parkmoses02/equilibrium/PCB/폐기/RevI_manufacturing_preview.png

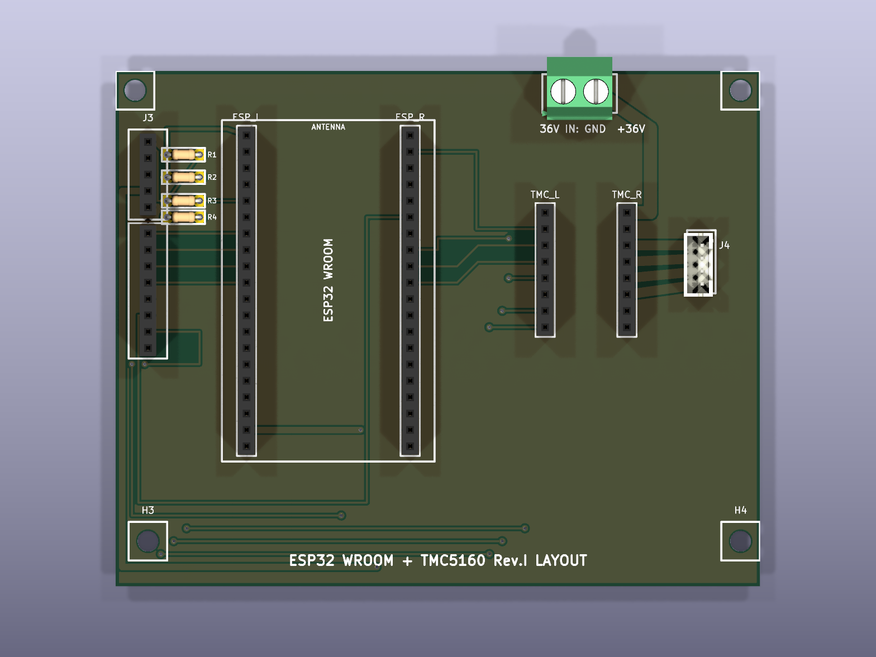
PCB/폐기/RevI_manufacturing_preview.png
