parkmoses02/equilibrium/README.md

# equilibrium
Double Inverted Pendulum Control - 6인 팀 프로젝트  이중 역진자 시스템의 동역학 모델링과 제어 알고리즘 구현을 위한 공동 개발 저장소입니다.

프로젝트 목표:
- 정확한 비선형/선형화 모델 개발
- 다양한 제어 기법(LQR, PID, MPC 등) 비교 및 적용
- 시뮬레이션 환경 구축 및 성능 분석
- 코드 품질과 문서화 유지
