parkmoses02/equilibrium/PCB/폐기/HARDWARE_SPEC.md

# 이중역진자 제어 PCB 하드웨어 사양

작성 기준: 2026-08-06  
상태: Rev.C WROOM 배선 완료 사양

## 1. 시스템 구성

- 제어기: Freenove ESP32 WROOM 보드
- 스테퍼 드라이버: TMC5160T Pro V1.0 모듈
- 스테퍼 모터: NEMA17, 17HS4401, 1.8° bipolar
- 엔코더: 광전 증분형 로터리 엔코더 38S6G5-B-G24N, 600 PPR
- 주 전원: DC 36 V
- 용도: 이중역진자 구동 및 위치/속도 계측

## 2. ESP32 WROOM 보드

- 보드: Freenove ESP32 WROOM
- 로직 전압: 3.3 V
- 보드 전원 입력: 5 V 핀 사용 예정
- 핀 피치: 2.54 mm
- GPIO6~GPIO11: Flash 연결 핀이므로 사용 금지
- GPIO16~GPIO17: WROOM 보드에서 사용 가능하지만 Rev.C PCB에서는 NC로 유지
- 카메라가 없는 WROOM 보드이므로 WROVER-CAM 카메라 핀 충돌 조건은 해당 없음
- ESP32 GPIO에는 3.3 V를 초과하는 신호를 직접 입력하지 않음

## 3. 스테퍼 모터

- 모델: 17HS4401
- 형식: 2상 bipolar hybrid stepper motor
- 프레임: NEMA17
- 스텝각: 1.8°/step
- 기본 스텝 수: 200 full steps/revolution
- 정격 상전류: 1.68 A/phase
- 정격 상전압: 3.27 V
- 상저항: 1.95 Ω ±10%
- 상인덕턴스: 4.4 mH ±20%
- 유지토크: 0.45 N·m
- 절연 등급: Class B
- 절연저항: 100 MΩ min (500 V DC)
- 중량: 0.3 kg
- 모터 길이: 40 mm
- 데이터시트 표기 동작환경: -20~+50 °C, 15~95% RH
- 결선: A+, A-, B+, B-의 4선
- 구동 방식: TMC5160의 전류 제한형 chopper 구동
- 주의: 36 V는 드라이버의 VMOT 전압이며 모터 코일에 36 V를 직접 연속 인가하는 방식이 아님

## 4. TMC5160 드라이버 모듈

- 모듈: TMC5160T Pro V1.0
- 모터 전원 VMOT: 36 V 입력 예정
- 로직 전원 VIO: ESP32와 동일한 3.3 V
- 제어: STEP/DIR + SPI
- 필수 신호: EN, STEP, DIR, MOSI, MISO, SCK, CS
- 모터 출력: A1, A2, B1, B2
- DIAG0/DIAG1: 현재 미사용
- ENCA/ENCB/ENCN: 현재 미사용
- 모듈 상단 보조 핀은 실제 모듈에 헤더가 납땜되지 않았으므로 캐리어 PCB에서도 사용하지 않는 방향
- 실제 연속 허용전류는 모듈의 방열판, 냉각 조건 및 제조사 사양을 기준으로 최종 확인 필요
- TMC5160 모듈 방열판 보유 및 사용 예정
- PCB에는 냉각팬 커넥터와 팬 전원회로를 넣지 않음
- 시운전 중 과열 시 외부 송풍으로 보조하고 SPI의 과열 사전 경고 상태를 확인

## 5. 엔코더

- 모델: 38S6G5-B-G24N
- 분해능: 600 PPR
- 케이블 길이: 약 1.5 m
- 형식: 광전 증분형, A/B 2상
- 출력: NPN open-collector로 알려져 있으나 제품 라벨/판매 사양으로 최종 확인 필요
- 전원 범위: 판매 사양에 따라 DC 5~24 V 또는 8~24 V로 표기되므로 실물 라벨 확인 필요
- 권장 PCB 인터페이스:
  - 엔코더를 5 V로 구동할 수 있는지 실물 사양 확인
  - A/B 출력에 각각 3.3 V 기준 외부 pull-up 적용
  - 초기값: 2.2~4.7 kΩ pull-up, 최고 RPM과 실측 파형에 따라 조정
  - 약 1.5 m 케이블의 노이즈 대책으로 입력 직렬 저항, ESD 보호 및 3.3 V Schmitt-trigger buffer 권장
  - 엔코더 케이블은 모터 배선과 분리하고 가능하면 shielded twisted-pair 사용
  - 엔코더 GND와 PCB GND 공통 연결
- 600 PPR는 A/B 4체배 시 최대 2400 counts/revolution으로 처리 가능

## 6. 전원 구조

- 입력 전원: DC 36 V
- 36 V 직접 공급 대상: TMC5160 VMOT
- 5 V 필요 대상: ESP32 보드, 엔코더(5 V 구동 가능 모델인 경우)
- 3.3 V 대상: TMC5160 VIO 및 ESP32 신호 pull-up
- 시스템 전원은 외부 power supply에서 36 V와 필요한 저전압을 공급하는 방향
- 36 V는 VMOT에만 연결하며 ESP32에는 직접 연결하지 않음
- ESP32용 5 V를 외부에서 별도로 공급하거나, 외부 DC-DC를 사용하는 것으로 잠정 결정
- 36 V와 5 V 입력은 분리하고 GND는 공통으로 구성
- 전원 입력부에 필요한 항목:
  - 역극성 보호
  - 퓨즈 또는 resettable fuse
  - 36 V 이상의 충분한 정격을 가진 TVS 검토
  - TMC5160 가까이에 bulk capacitor 및 ceramic bypass capacitor
  - 5 V regulator 입력/출력 capacitor

### 6.1 외부 36 V 전원공급기와 입력 배선 사양

- 권장 전원공급기: 정전압형 DC 36 V, 정격출력 3 A 이상
  - 36 V/5 A 제품도 사용할 수 있으나, 전원공급기의 큰 정격전류가 PCB로 그대로 흐르지 않도록 PCB 입력 앞에 별도 퓨즈를 둔다.
  - 출력전압 조절형 제품은 PCB 연결 전에 멀티미터로 36 V인지 확인한다.
  - 출력 과전류·단락·과전압·과열 보호 기능이 있는 제품을 우선한다.
  - AC 입력 단자와 금속 케이스가 있는 전원공급기는 보호접지(PE), 절연 덮개 및 케이스를 적용한다. AC 주전원 배선은 이 PCB에 연결하지 않는다.
- PSU와 PCB 사이 36 V 입력선:
  - 도체: 연선 구리선(stranded copper)
  - 권장 굵기: AWG18, 약 0.75~0.82 mm²
  - 짧은 시험 배선에서만 AWG20 사용 가능하며, 이 경우에도 3 A 이하 퓨즈를 적용한다.
  - `+36V`와 `GND`는 같은 굵기와 비슷한 길이로 배선한다.
  - 절연 정격은 최소 DC 60 V 이상, 구매 시에는 일반적인 300 V 또는 600 V 정격 전선을 권장한다.
  - 듀퐁 점퍼선, 브레드보드선 및 정격을 알 수 없는 가는 케이블은 VMOT 입력에 사용하지 않는다.
- 퓨즈 및 퓨즈 홀더:
  - 위치: PSU의 `+36V` 출력 직후, 가능한 한 전원공급기 가까이 설치
  - 권장값: 2.5~3 A 지연형(time-delay/slow-blow)을 초기값으로 사용
  - 퓨즈와 홀더 모두 DC 60 V 이상 및 사용 전류 이상의 정격 제품을 사용
  - 모터 가속 시 정상적으로 퓨즈가 끊어지면 실측 입력전류를 확인한 후 조정하며, PCB의 2 A 연속 설계 기준을 임의로 넘기지 않는다.
- PCB 전원 단자:
  - 풋프린트: 5.08 mm pitch, 3핀 단자대
  - 실제 장착 부품은 최소 DC 60 V/5 A 이상, 권장 300 V/8 A 이상의 정격을 확인한다.
  - 단자대의 허용 전선 단면적에 AWG18이 포함되는지 확인한다.
- 페룰 단자:
  - AWG18 전선에는 0.75 mm²용 절연 페룰 사용(E7508 또는 단자대 삽입 깊이에 맞는 동급 규격)
  - 금속 슬리브 길이는 우선 8 mm를 사용하고, 단자대 제조사 권장 피복 제거 길이에 맞춘다.
  - 래칫식 사각 또는 육각 페룰 압착기로 압착하고, 납을 먹인 연선 끝을 나사 단자대에 직접 체결하지 않는다.
  - 압착 후 가볍게 당겨 빠지지 않는지 확인하고, 구리 가닥이 단자 밖으로 노출되지 않게 한다.

권장 연결 순서:

```text
PSU +36V ── 2.5~3 A 지연형 퓨즈 ── AWG18 적색선 + 0.75 mm² 페룰 ── PCB VMOT
PSU GND  ───────────────────────── AWG18 흑색선 + 0.75 mm² 페룰 ── PCB GND
```

초기 통전 전에는 PSU를 끄고 극성 및 단락 여부를 확인한다. 모터 또는 TMC5160 모듈은 VMOT가 인가된 상태에서 연결하거나 분리하지 않는다.

## 7. PCB 배선 설계 기준(잠정)

- PCB: 2 layer 가정
- 동박: 1 oz 가정
- 외층 허용 온도 상승: 10 °C 목표
- 모터 상전류 계산 기준: 1.68 A/phase 정격, 설계 여유를 위해 2.0 A 연속 기준 적용 예정
- VMOT 및 모터 A/B 배선: 전류 기준으로 폭 계산 후 적용
- 신호선: 0.25~0.30 mm 이상 권장
- GND: 양면 ground plane 및 stitching via 적용
- 모터 전류 루프는 짧고 굵게 구성
- SPI/엔코더 신호는 모터 출력 및 VMOT 배선과 이격
- 전원·모터 커넥터와 핀헤더의 정격전류가 PCB 패턴보다 낮지 않은지 확인

### 7.1 전류별 패턴 폭 계산 및 최종 적용값

계산 가정:

- 2층 PCB, 외층 배선
- 1 oz copper, 약 35 µm 두께
- 허용 온도 상승 10 °C
- IPC-2221 외층 경험식 기준의 보수적 1차 계산
- 실제 적용 폭은 계산 최소값보다 넓게 선정

| 배선 종류 | 설계전류 | 계산 최소 폭 | PCB 적용 폭 | 비고 |
|---|---:|---:|---:|---|
| VMOT 36 V | 2.0 A 기준 | 약 0.78 mm | 2.00 mm | bulk capacitor와 TMC 사이를 짧게 구성 |
| 모터 A1/A2/B1/B2 | 2.0 A 연속 기준 | 약 0.78 mm | 1.50 mm | 모터 정격 1.68 A/phase에 여유 적용 |
| 외부 5 V 전원 | 1.0 A 잠정 | 약 0.30 mm | 1.00 mm | ESP32와 엔코더 공급 |
| 3.3 V 로직 | 0.5 A 미만 | 0.30 mm 미만 | 0.50 mm | TMC VIO 및 pull-up |
| SPI/STEP/DIR/EN | 수 mA | 제조 최소폭 이하 | 0.30 mm | 모터선과 이격 |
| 엔코더 A/B | 수 mA | 제조 최소폭 이하 | 0.30 mm | 1.5 m 케이블, 4.7 kΩ pull-up 및 100 Ω 직렬저항 |

패턴 폭보다 핀헤더, 단자대, 납땜 상태 및 TMC5160 모듈의 방열 조건이 먼저 전류 한계가 될 수 있으므로 이 부품들의 정격도 함께 확인한다.

### 7.2 Rev.C WROOM에 적용한 배선 구조

- F.Cu/B.Cu 양면을 사용해 신호 교차를 분리
- F.Cu와 B.Cu에 GND copper zone 적용
- VMOT 및 모터 출력은 신호선보다 넓게 배선
- 엔코더 A/B는 GPIO34/GPIO35에 연결
- 엔코더 입력마다 4.7 kΩ 3.3 V pull-up과 100 Ω 직렬저항 적용
- TMC5160 상단 DIAG0/DIAG1/ENCA/ENCB/ENCN은 미사용 및 캐리어 풋프린트에서 제외
- 냉각팬 회로와 팬 커넥터는 제외
- Freenove ESP32 WROOM 2×20 핀맵 적용
- WROVER-CAM에서 GND였던 위치 중 WROOM의 GPIO17/GPIO16 위치는 GND 연결을 제거하고 NC 처리
- KiCad 10 DRC 결과는 Rev.C 생성 후 별도 보고서 기준
- 잔여 DRC 항목은 사용자 정의 풋프린트 라이브러리 및 silkscreen 겹침 관련 비전기적 경고
- GND zone은 F.Cu/B.Cu 양면 모두 채운 상태로 저장

## 8. 배선 후 제작 전 확인 필요 항목

1. 외부 power supply의 5 V 출력 제공 여부와 최대 전류
2. 구매할 36 V 전원공급기의 정확한 모델, 보호 기능 및 출력 단자 구조
3. TMC5160T Pro 모듈의 정확한 구매 링크 또는 뒷면 사진
4. 엔코더 실물 라벨 및 케이블 색상별 기능(V+, GND, A, B, shield)
5. 모터 예상 최고 회전속도와 연속 운전시간
6. 사용할 전원·모터·엔코더 커넥터 종류와 정격
7. PCB 동박 1 oz/2 oz 선택과 보드 제작업체 최소 선폭/간격
8. Freenove WROOM 실물의 핀열 간격과 방향 1:1 출력 확인
9. 실제 장착할 5.08 mm 전원 단자대의 전압·전류·허용 전선 규격 확인

## 9. 참고 자료

- Analog Devices TMC5160 제품 정보: https://www.analog.com/en/products/tmc5160.html
- TMC5160 데이터시트: https://www.analog.com/media/en/technical-documentation/data-sheets/tmc5160a_datasheet_rev1.18.pdf
- Freenove ESP32 WROOM 제품 핀맵: 사용자 제공 이미지 기준

> 이 문서는 PCB 설계를 위한 작업 사양이다. 모델명이 같은 모터와 엔코더도 판매처에 따라 전기 사양이 달라질 수 있으므로, 최종 배선 및 부품 선정 전에 실물 라벨과 구매 사양을 우선한다.

## 10. Rev.E 커넥터 및 전원 확정 사양 (2026-08-08)

- 사용 조건: 제어 UI 사용을 위해 ESP32 USB를 항상 PC에 연결한다.
- 외부 5 V 입력 단자와 36 V→5 V 변환 회로는 PCB에서 제외한다.
- ESP32와 엔코더의 5 V는 ESP32 USB 5 V 레일에서 공급한다.
- 36 V 입력은 TMC5160의 VMOT 전원에만 사용하며 ESP32 5 V 핀에 연결하지 않는다.

| 위치 | 용도 | 최종 실장 부품 | 피치/핀 수 | 비고 |
|---|---|---|---|---|
| U1 | Freenove ESP32 WROOM | 1열 암소켓 2개 | 2.54 mm, 1×20 ×2 | 보드 탈착식 |
| U2 | TMC5160T Pro | 1열 암소켓 2개 | 2.54 mm, 1×8 ×2 | 모듈 방열판 공간 확보 |
| J2 | 예비 GPIO | 1열 암소켓 | 2.54 mm, 1×8 | IO32, IO33 포함 |
| J3 | 엔코더 | 1열 암소켓 | 2.54 mm, 1×5 | A, B, GND, USB +5V, GND |
| J4 | 스테퍼 모터 | JST-PH B4B-PH-K PCB 수헤더 | 2.00 mm, 1×4 | A2, A1, B2, B1 순서 |
| J1 | 36 V 입력 | 2핀 나사 단자대 | 5.08 mm, 1×2 | GND, +36V 순서 |

### 구매·조립 조건

- J4 하우징은 JST PHR-4, PCB 수헤더는 B4B-PH-K 계열을 사용한다.
- JST-PH는 정격 여유가 크지 않으므로 정품 접점과 제조사 지정 압착 공구를 사용하고, 접점 규격에 맞는 AWG24 연선을 사용한다.
- 17HS4401의 1.68 A/상 연속 운전 시 커넥터 및 케이블 온도를 반드시 확인한다. 커넥터가 뜨거워지면 전류를 낮추거나 JST-VH 등 상위 전류 정격 커넥터로 변경한다.
- 듀퐁 점퍼선은 모터 출력에 사용하지 않는다.
- J1 단자대는 최소 DC 60 V/5 A 이상, AWG18 수용 제품으로 선정한다.
- PSU–PCB 배선은 AWG18 연선과 0.75 mm² 페룰을 사용한다.
- USB 전원이 끊기면 ESP32와 엔코더도 꺼진다. 36 V만 공급해서는 제어부가 동작하지 않는다.
- 외부 5 V를 ESP32 5 V 핀에 별도로 주입하지 않는다.

### Rev.F 3D 모델 연결

- U1: 1×20, 2.54 mm 암소켓 2개
- U2: 1×8, 2.54 mm 암소켓 2개
- J2: 1×8, 2.54 mm 암소켓 1개
- J3: 1×5, 2.54 mm 암소켓 1개
- J4: JST-PH B4B-PH-K, 4핀 2.00 mm 수직 수헤더
- J1: 2핀 5.08 mm 수평 인입 나사 단자대
- R1~R4: DIN0204, 피치 5.08 mm 축형 저항
- ESP32 WROOM 및 TMC5160 모듈 본체는 전용 STEP 모델이 없어 소켓만 표시한다.
- 3D 모델은 조립 방향과 기구 간섭 확인용이며 Gerber와 전기적 연결에는 영향을 주지 않는다.

### Rev.G 모듈 핀열 간격 수정

- ESP32 WROOM U1 좌우 핀열 중심 간격: 27.94 mm에서 **25.40 mm**로 수정
- TMC5160 U2 좌우 핀열 중심 간격: 15.24 mm에서 **12.70 mm**로 수정
- 두 모듈 모두 중앙 위치를 유지하고 좌우 핀열을 각각 1.27 mm 안쪽으로 이동
- 같은 핀열의 상하 피치는 기존과 동일한 2.54 mm
- 이전 Rev.F 및 그 이전 버전은 모듈 핀열 간격 오류가 있으므로 PCB 제작에 사용하지 않는다.
- 최종 발주 전 실물 모듈의 좌우 핀 중심 간격을 캘리퍼스로 다시 확인한다.
