parkmoses02/equilibrium/PCB/폐기/revF_3d_preview.png

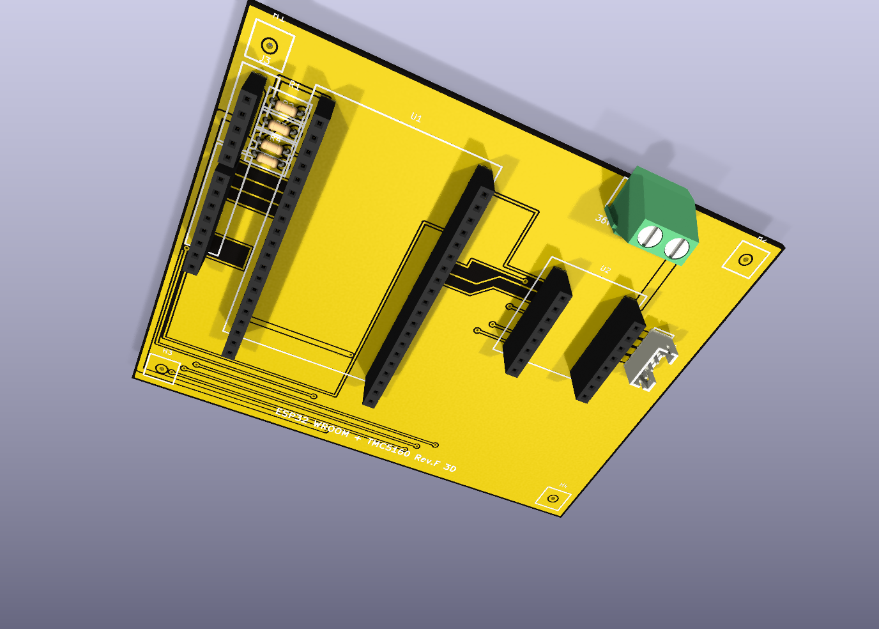
PCB/폐기/revF_3d_preview.png
