parkmoses02/equilibrium/PCB/폐기/revH_3d_preview.png

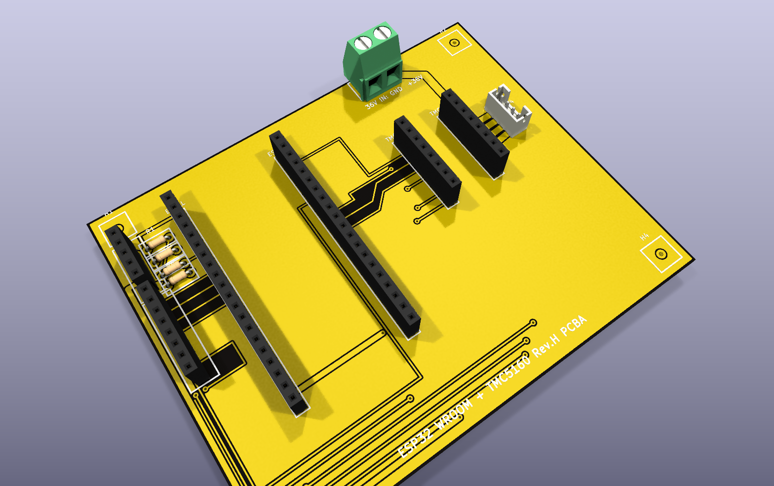
PCB/폐기/revH_3d_preview.png
