parkmoses02/equilibrium/PCB/폐기/revI_top_preview.png

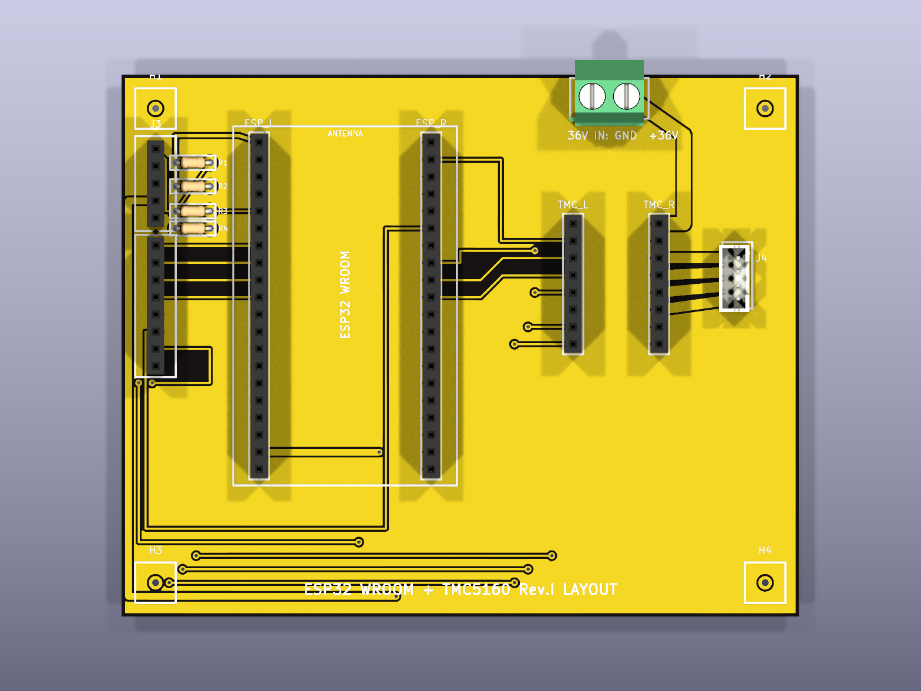
PCB/폐기/revI_top_preview.png
