parkmoses02/equilibrium/PCB/폐기/RevI_manufacturing_drill_report.txt

Drill report for esp32_wroom_tmc5160_carrier_revI_gerber_source.kicad_pcb
Created on 2026-08-10T13:18:06

Copper Layer Stackup:
    =============================================================
    L1 :  F.Cu                      front
    L2 :  B.Cu                      back

Drill file 'esp32_wroom_tmc5160_carrier_revI_gerber_source-PTH.drl' contains
    plated through holes:
    =============================================================
    T1  0.500mm  0.0197"  (15 holes))
    T2  0.750mm  0.0295"  (4 holes))
    T3  1.000mm  0.0394"  (77 holes))
    T4  1.300mm  0.0512"  (2 holes))

    Total plated holes count 98

Drill file 'esp32_wroom_tmc5160_carrier_revI_gerber_source-NPTH.drl' contains
    unplated through holes:
    =============================================================
    T1  3.200mm  0.1260"  (4 holes))

    Total unplated holes count 4
