parkmoses02/equilibrium/PCB/폐기/esp32_wroom_tmc5160_carrier_revE_ph2_connectors.kicad_pcb

## KiCad design PCB/폐기/esp32_wroom_tmc5160_carrier_revE_ph2_connectors.kicad_pcb (2026-08-08)

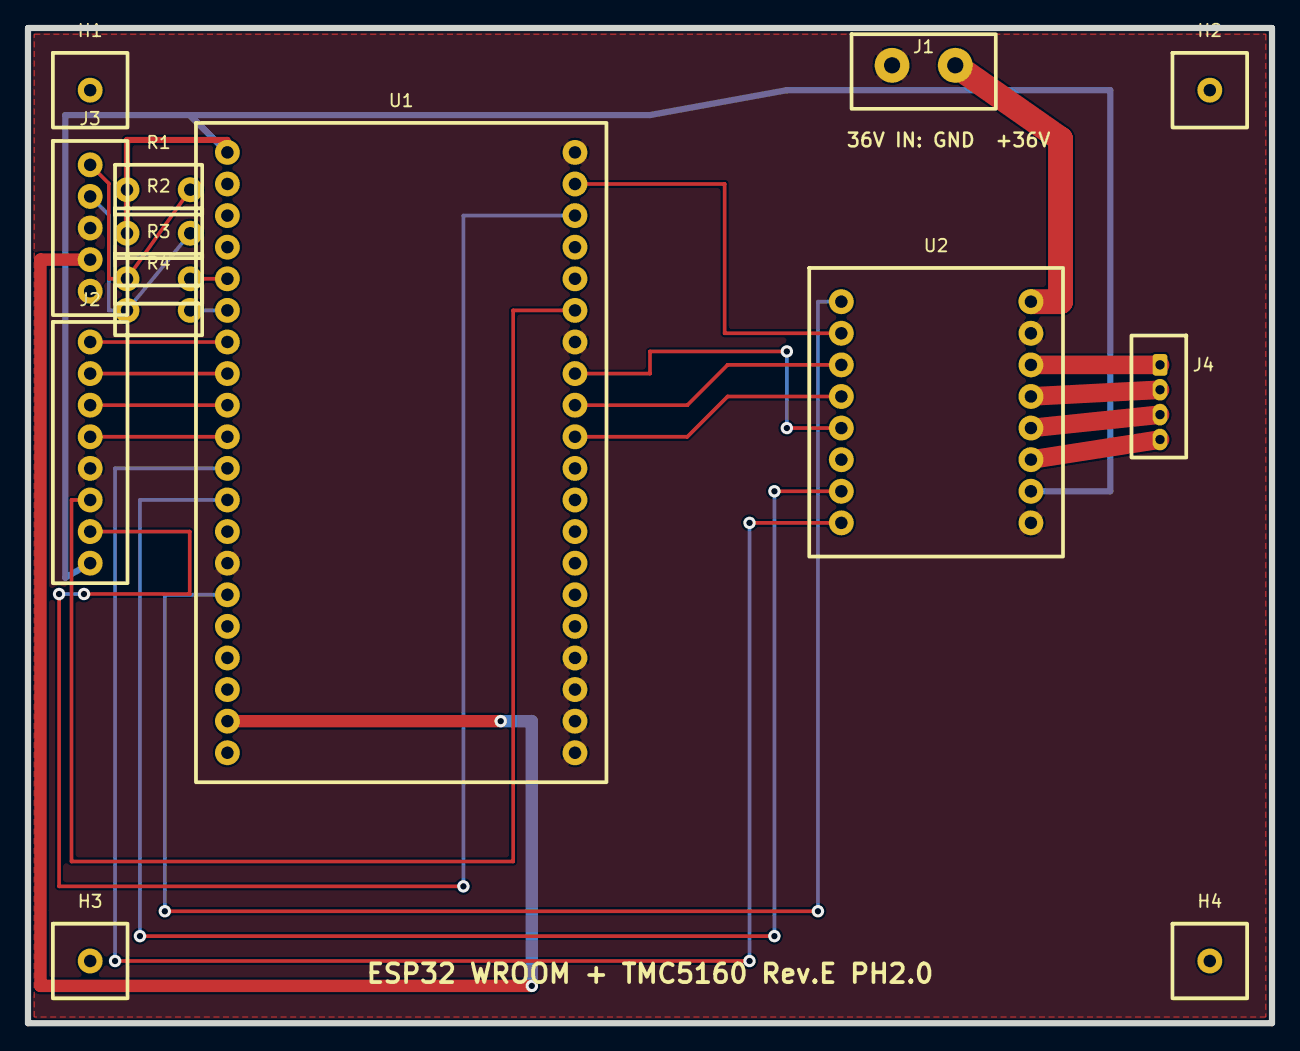
[picture p6: board esp32_wroom_tmc5160_carrier_revE_ph2_connectors.kicad_pcb from above]

Board: 2 copper layers, 100.0 x 80.0 mm, 14 parts (0 on the bottom side), 25 nets.

Parts:
H1, H2, H3, H4: M3_MOUNT
J1: 36V INPUT 2P 5.08mm TERMINAL; TERMINAL_BLOCK_2P_5.08
J2: SPARE GPIO / 1x8 2.54mm FEMALE SOCKET; IO_1x8_2.54_VERTICAL
J3: ENCODER / 1x5 2.54mm FEMALE SOCKET; ENCODER_1x5_2.54_VERTICAL
J4: JST-PH B4B-PH-K 4-pin 2.00mm MALE; JST_PH_B4B-PH-K_1x04_P2.00mm_Vertical
R1: R_A_PULLUP_4K7
R2: R_B_PULLUP_4K7
R3: R_A_SERIES_100R
R4: R_B_SERIES_100R
U1: FREENOVE ESP32 WROOM / 1x20 2.54mm FEMALE SOCKET 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; FREENOVE_ESP32_WROOM_2x20
U2: TMC5160T PRO / 1x8 2.54mm FEMALE SOCKET x2; TMC5160T_PRO_2x8

Connections:
+3V3: J2.8, R1.1, R2.1, U1.L1, U2.15
+5V: J3.4, U1.L19
ENC_A: R3.2, U1.L5
ENC_A_RAW: J3.1, R1.2, R3.1
ENC_B: R4.2, U1.L6
ENC_B_RAW: J3.2, R2.2, R4.1
GND: J1.1, J2.5, J3.3, J3.5, U1.L14, U1.R1, U1.R7, U1.R17, U1.R18, U1.R19, U1.R20, U2.10, U2.16
IO21: J2.6, U1.R6
IO22: J2.7, U1.R3
IO25: J2.3, U1.L9
IO26: J2.4, U1.L10
IO32: J2.1, U1.L7
IO33: J2.2, U1.L8
M_A1: J4.2, U2.12
M_A2: J4.1, U2.11
M_B1: J4.4, U2.14
M_B2: J4.3, U2.13
SPI_CS: U1.R10, U2.4
SPI_MISO: U1.R8, U2.5
SPI_MOSI: U1.R2, U2.2
SPI_SCK: U1.R9, U2.3
TMC_DIR: U1.L11, U2.8
TMC_EN: U1.L15, U2.1
TMC_STEP: U1.L12, U2.7
VMOT: J1.2, U2.9
