parkmoses02/equilibrium/PCB/폐기/esp32_tmc5160_carrier_revA.kicad_pcb

## KiCad design PCB/폐기/esp32_tmc5160_carrier_revA.kicad_pcb (2026-08-06)

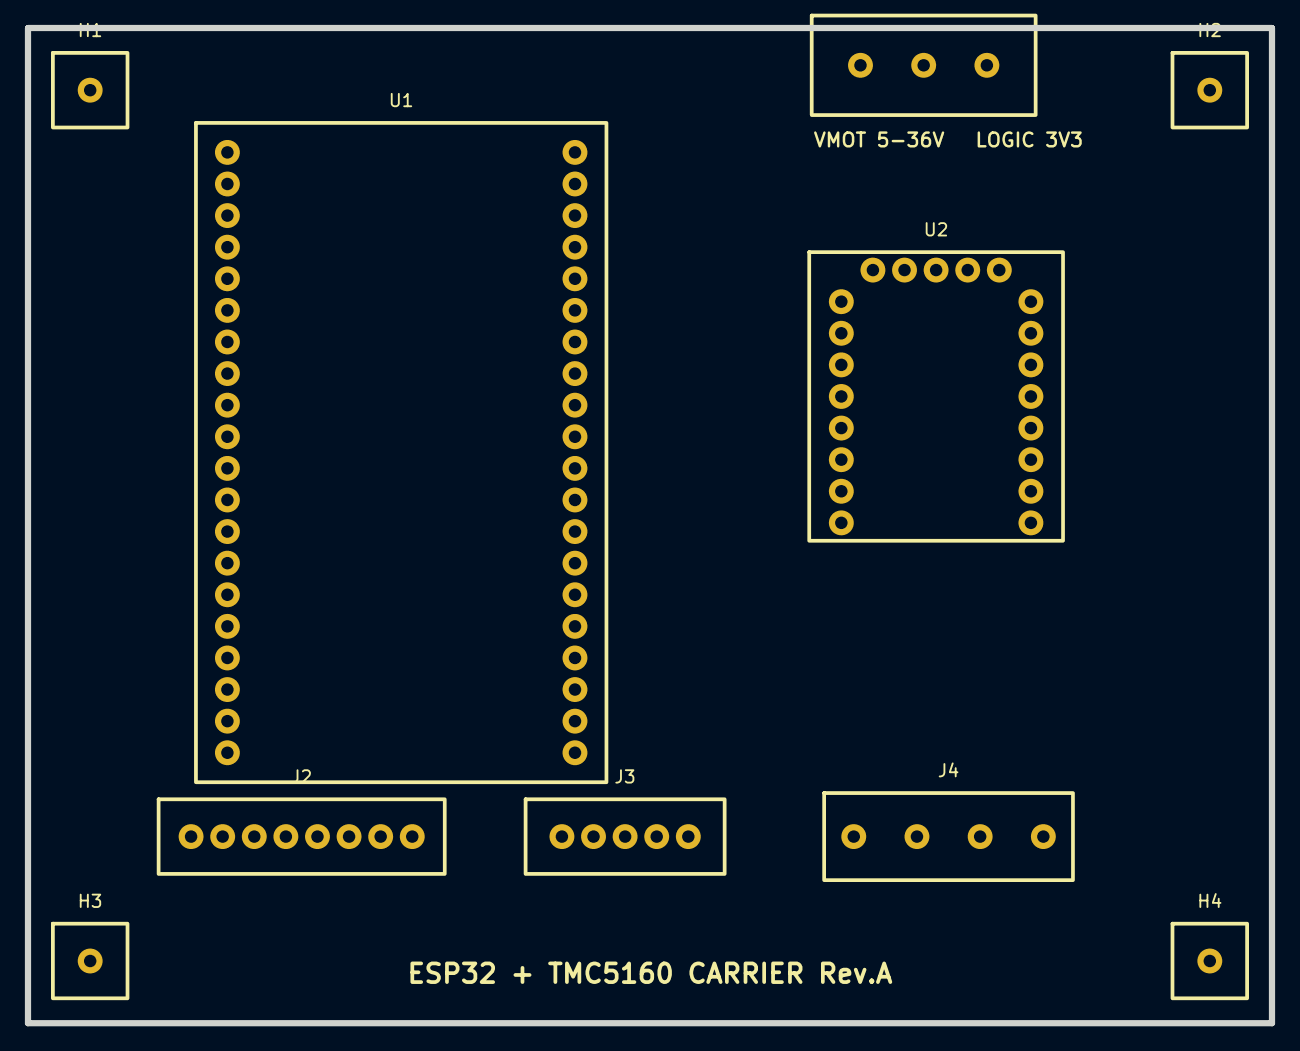
[picture p7: board esp32_tmc5160_carrier_revA.kicad_pcb from above]

Board: 2 copper layers, 100.0 x 80.0 mm, 10 parts (0 on the bottom side), 24 nets, no tracks yet.

Parts:
H1, H2, H3, H4: M3_MOUNT
J1: POWER_VMOT_3P_5.08
J2: IO_1x8_2.54
J3: ENCODER_1x5_2.54
J4: MOTOR_1x4_5.08
U1: FREENOVE_ESP32_WROVER_CAM_2x20
U2: TMC5160T_PRO_2x8

Connections:
+3V3: J2.8, U1.L1, U2.15
+5V: J1.2, J3.4, U1.L19
ENC_A: J3.2, U2.20
ENC_B: J3.1, U2.19
ENC_N: J3.5, U2.21
GND: J1.1, J2.1, J3.3, U1.L14, U1.R1, U1.R7, U1.R11, U1.R12, U1.R20, U2.10, U2.16
IO21: J2.2, U1.R6
IO22: J2.3, U1.R3
IO25: J2.4, U1.L9
IO26: J2.5, U1.L10
IO32: J2.6, U1.L7
IO33: J2.7, U1.L8
M_A1: J4.1, U2.12
M_A2: J4.2, U2.11
M_B1: J4.3, U2.14
M_B2: J4.4, U2.13
SPI_CS: U1.R10, U2.4
SPI_MISO: U1.R8, U2.5
SPI_MOSI: U1.R2, U2.2
SPI_SCK: U1.R9, U2.3
TMC_DIR: U1.L11, U2.8
TMC_EN: U1.L15, U2.1
TMC_STEP: U1.L12, U2.7
VMOT: J1.3, U2.9
