parkmoses02/equilibrium/PCB/폐기/esp32_wroom_tmc5160_carrier_revI_manufacturing_fixed.kicad_pcb

## KiCad design PCB/폐기/esp32_wroom_tmc5160_carrier_revI_manufacturing_fixed.kicad_pcb (2026-08-10)

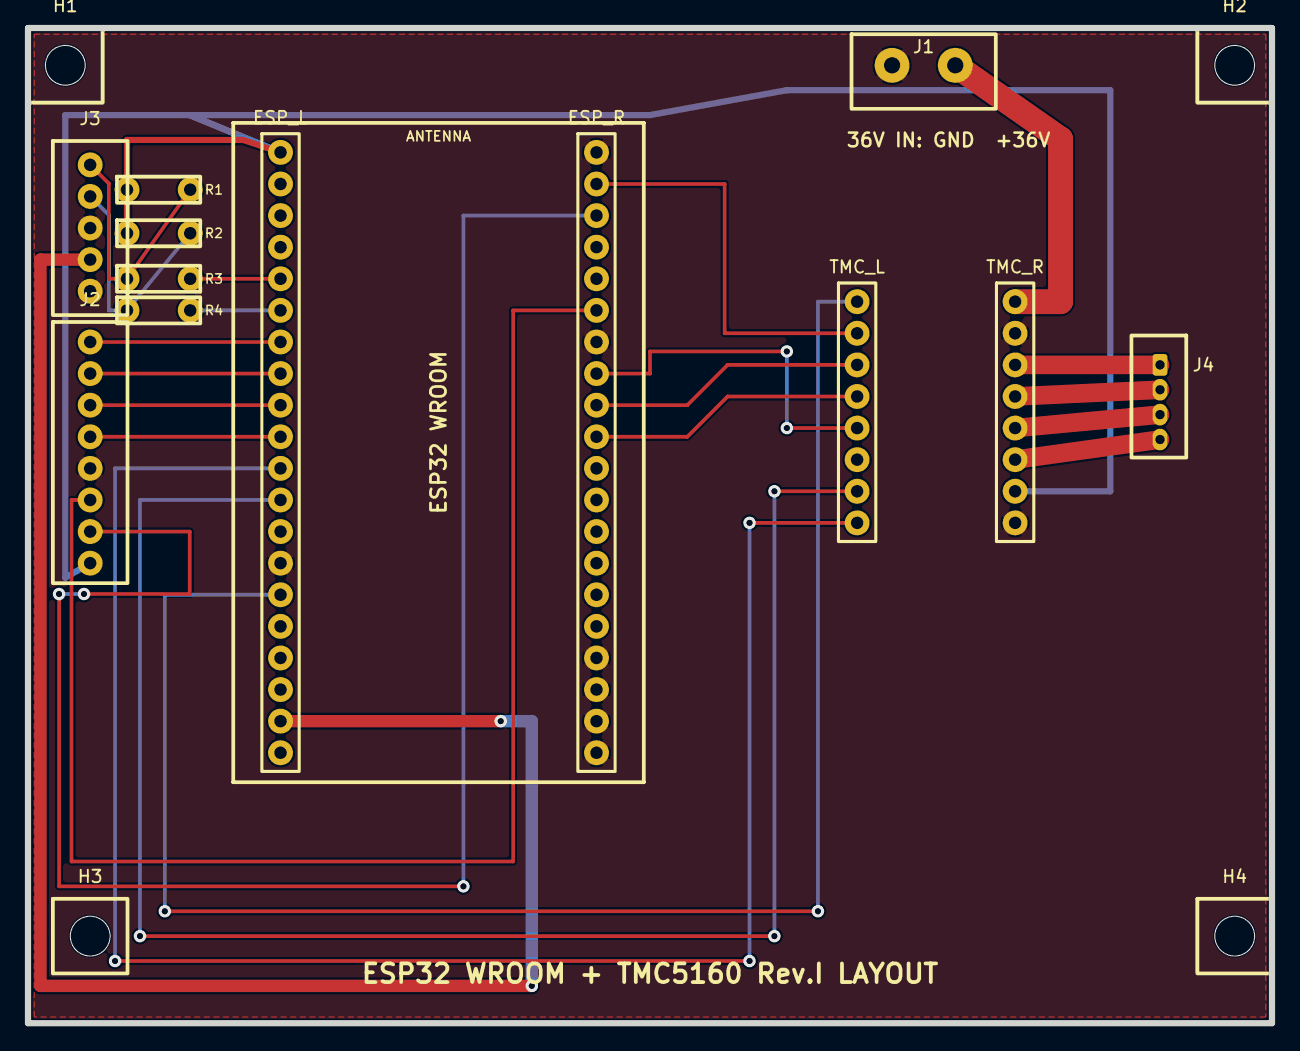
[picture p8: board esp32_wroom_tmc5160_carrier_revI_manufacturing_fixed.kicad_pcb from above]

Board: 2 copper layers, 100.0 x 80.0 mm, 16 parts (0 on the bottom side), 25 nets.

Parts:
ESP_L: 1x20 2.54mm FEMALE SOCKET; ESP_L_1x20_PCBA
ESP_R: 1x20 2.54mm FEMALE SOCKET; ESP_R_1x20_PCBA
H1, H2, H3, H4: M3_MOUNT
J1: 36V INPUT 2P 5.08mm TERMINAL; TERMINAL_BLOCK_2P_5.08
J2: SPARE GPIO / 1x8 2.54mm FEMALE SOCKET; IO_1x8_2.54_VERTICAL
J3: ENCODER / 1x5 2.54mm FEMALE SOCKET; ENCODER_1x5_2.54_VERTICAL
J4: JST-PH B4B-PH-K 4-pin 2.00mm MALE; JST_PH_B4B-PH-K_1x04_P2.00mm_Vertical
R1: R_A_PULLUP_4K7
R2: R_B_PULLUP_4K7
R3: R_A_SERIES_100R
R4: R_B_SERIES_100R
TMC_L: 1x8 2.54mm FEMALE SOCKET; TMC_L_1x08_PCBA
TMC_R: 1x8 2.54mm FEMALE SOCKET; TMC_R_1x08_PCBA

Connections:
+3V3: ESP_L.L1, J2.8, R1.1, R2.1, TMC_R.15
+5V: ESP_L.L19, J3.4
ENC_A: ESP_L.L5, R3.2
ENC_A_RAW: J3.1, R1.2, R3.1
ENC_B: ESP_L.L6, R4.2
ENC_B_RAW: J3.2, R2.2, R4.1
GND: ESP_L.L14, ESP_R.R1, ESP_R.R7, ESP_R.R17, ESP_R.R18, ESP_R.R19, ESP_R.R20, J1.1, J2.5, J3.3, J3.5, TMC_R.10, TMC_R.16
IO21: ESP_R.R6, J2.6
IO22: ESP_R.R3, J2.7
IO25: ESP_L.L9, J2.3
IO26: ESP_L.L10, J2.4
IO32: ESP_L.L7, J2.1
IO33: ESP_L.L8, J2.2
M_A1: J4.2, TMC_R.12
M_A2: J4.1, TMC_R.11
M_B1: J4.4, TMC_R.14
M_B2: J4.3, TMC_R.13
SPI_CS: ESP_R.R10, TMC_L.4
SPI_MISO: ESP_R.R8, TMC_L.5
SPI_MOSI: ESP_R.R2, TMC_L.2
SPI_SCK: ESP_R.R9, TMC_L.3
TMC_DIR: ESP_L.L11, TMC_L.8
TMC_EN: ESP_L.L15, TMC_L.1
TMC_STEP: ESP_L.L12, TMC_L.7
VMOT: J1.2, TMC_R.9
