parkmoses02/equilibrium/(commit log)

2026-04-03 ㅇㄹㅇㄹㅇ
2026-04-03 uv 사용법
2026-04-03 파일 정리
2026-05-24 Replace magdi branch with current Balance_ESP32C3_1_1 workspace
    [MyData.h, Pendulum.cpp, Pendulum.h, Speed.cpp, Speed.h, main.cpp, panel.py]
2026-05-25 시뮬구체화
2026-08-06 Update pin map for ESP32 WROOM Rev.C
2026-08-06 Add ESP32 WROOM TMC5160 PCB design
    [esp32_tmc5160_carrier_revA.kicad_pcb, esp32_tmc5160_carrier_revB_routed.kicad_pcb, esp32_wroom_tmc5160_carrier_revC_routed.kicad_pcb, pinmap.csv]
2026-08-08 파워서플라이어 - PCB 전선 및 단자 스펙 정리
2026-08-08 Rev. E. PCB 기판 최종본 (3D 미리보기는 안 됨)
    [esp32_wroom_tmc5160_carrier_revD_connectors.kicad_pcb, esp32_wroom_tmc5160_carrier_revE_ph2_connectors.kicad_pcb]
2026-08-08 PCB Rev.E 누락된거 추가
2026-08-08 3D 모델링 추가된 Rev.F
    [esp32_wroom_tmc5160_carrier_revF_3d.kicad_pcb]
2026-08-08 PCB 치수 안 맞던거 수정 완료 Rev.G
    [esp32_wroom_tmc5160_carrier_revG_corrected_pitch.kicad_pcb]
2026-08-08 진짜최종수정본이길 REV.L
    [RevG_BOM.csv, RevH_BOM.csv, RevI_BOM.csv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]
2026-08-10 PCB 오류 수정
    [esp32_wroom_tmc5160_carrier_revI_manufacturing_fixed.kicad_pcb]
2026-08-10 cpl 수정.
    [RevI_CPL_JLCPCB_FIXED.csv, RevI_CPL_positiveY_backup_20260811.csv]
2026-08-10 Rev.J 진짜진짜진짜 최종본
    [RevG_BOM.csv, RevH_BOM.csv, RevI_BOM.csv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]
2026-09-11 캘리브레이션 코드 및 캘리브레이션된 제어코드
2026-09-14 main 살짝 수정
2026-09-14 stepdir버전 코드 작성
2026-09-15 STEP/DIR 코드를 걷어내고 SD_MODE=0 전용으로 되돌림
    STEP/DIR 방식은 stepdir 브랜치로 분리했다. 이 브랜치는 칩 내장 모션
    컨트롤러(SD_MODE=0) 한 가지만 쓴다. b29ef2e 를 되돌리되, STEP/DIR 과 무관한
    두 가지는 유지한다.
    - 삭제: lib/TMC/TMCStepDir.{h,cpp}, src/tests/stepdir_backend_test.cpp,
    src/tests/tmc5160_diagnostics.cpp, platformio.ini 의 해당 환경 2개
    - main.cpp 는 다시 TMC 를 직접 인스턴스화한다 (USE_STEPDIR_BACKEND 분기 제거)
    - TMC 의 virtual/가상 소멸자 제거 - 파생 백엔드가 없다
    - upright_balance_test.cpp 는 STEP/DIR 개조 이전 버전으로 복귀
    - 유지한 개선: 헤더 #pragm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
2026-09-15 STEP 핀을 직접 두드리던 테스트 제거
    이 브랜치는 칩 내장 램프(SD_MODE=0) 한 가지만 쓴다. STEP/DIR 펄스를
    digitalWrite 로 만들던 테스트는 stepdir 브랜치에 있으므로 여기서는 지운다.
    - src/tests/upright_balance_test.cpp
    - src/tests/tmc5160_oscillation.cpp
    - manual_tests/tmc5160_oscillation/ (위 파일의 구버전 사본을 담은 별도 프로젝트)
    - platformio.ini 의 해당 환경 2개
    모터를 건드리지 않는 encoder_calibration 은 그대로 둔다.
    esp32dev / encoder_calibration 빌드 확인.
